Muhammad-Anees99/Ambulator/Press Test.png

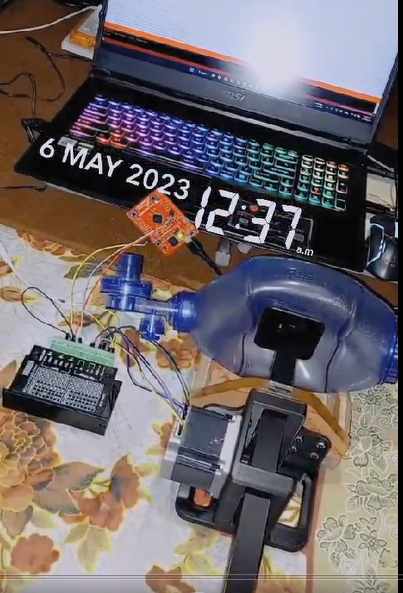
Press Test.png
