Muhammad-Anees99/Ambulator/Test.png

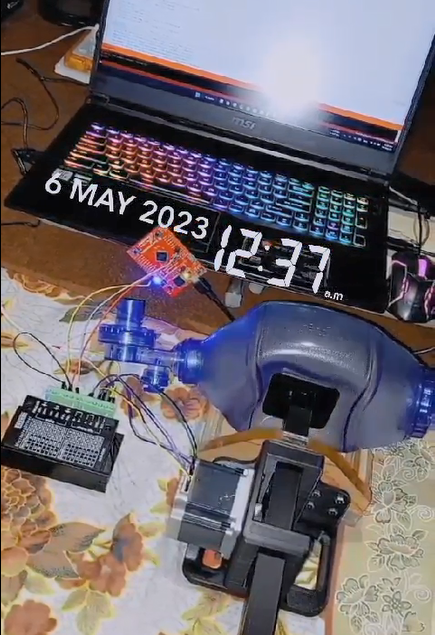
Test.png
