Muhammad-Anees99/Ambulator/README.md

Ambulator
"Embedded Systems-I X Mechanisms"
This project is one of the best project in which a Portable Ventilator is made using Microcontroller and Proper Mechanism Assembly with programming and Proper Hardware and Final Design.
More details are in Project Report Folder.
