Muhammad-Anees99/Ambulator/Control Part.png

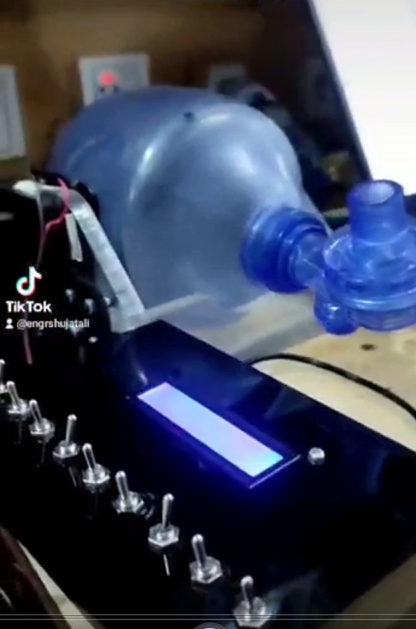
Control Part.png
