Muhammad-Anees99/Ambulator/Top View.png

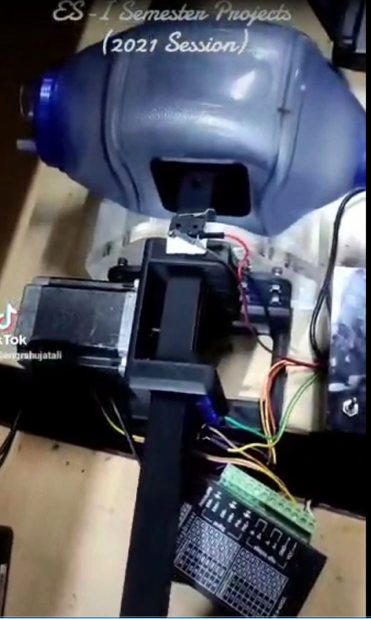
Top View.png
